wisnia1998/DDS-generator/README.md

# DDS-generator
DDS generator based on Adruino board and AD9850 for PUE student classes

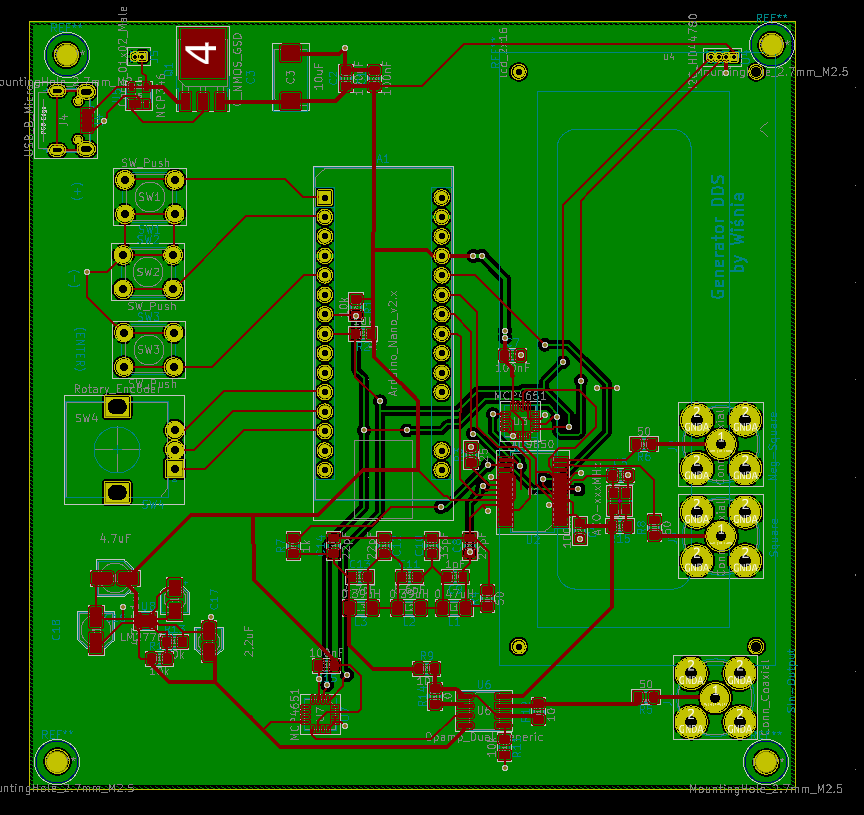
[picture p1: PCB_DDS.PNG]
