wisnia1998/DDS-generator/dds.kicad_pcb

## KiCad design dds.kicad_pcb (2020-10-13)

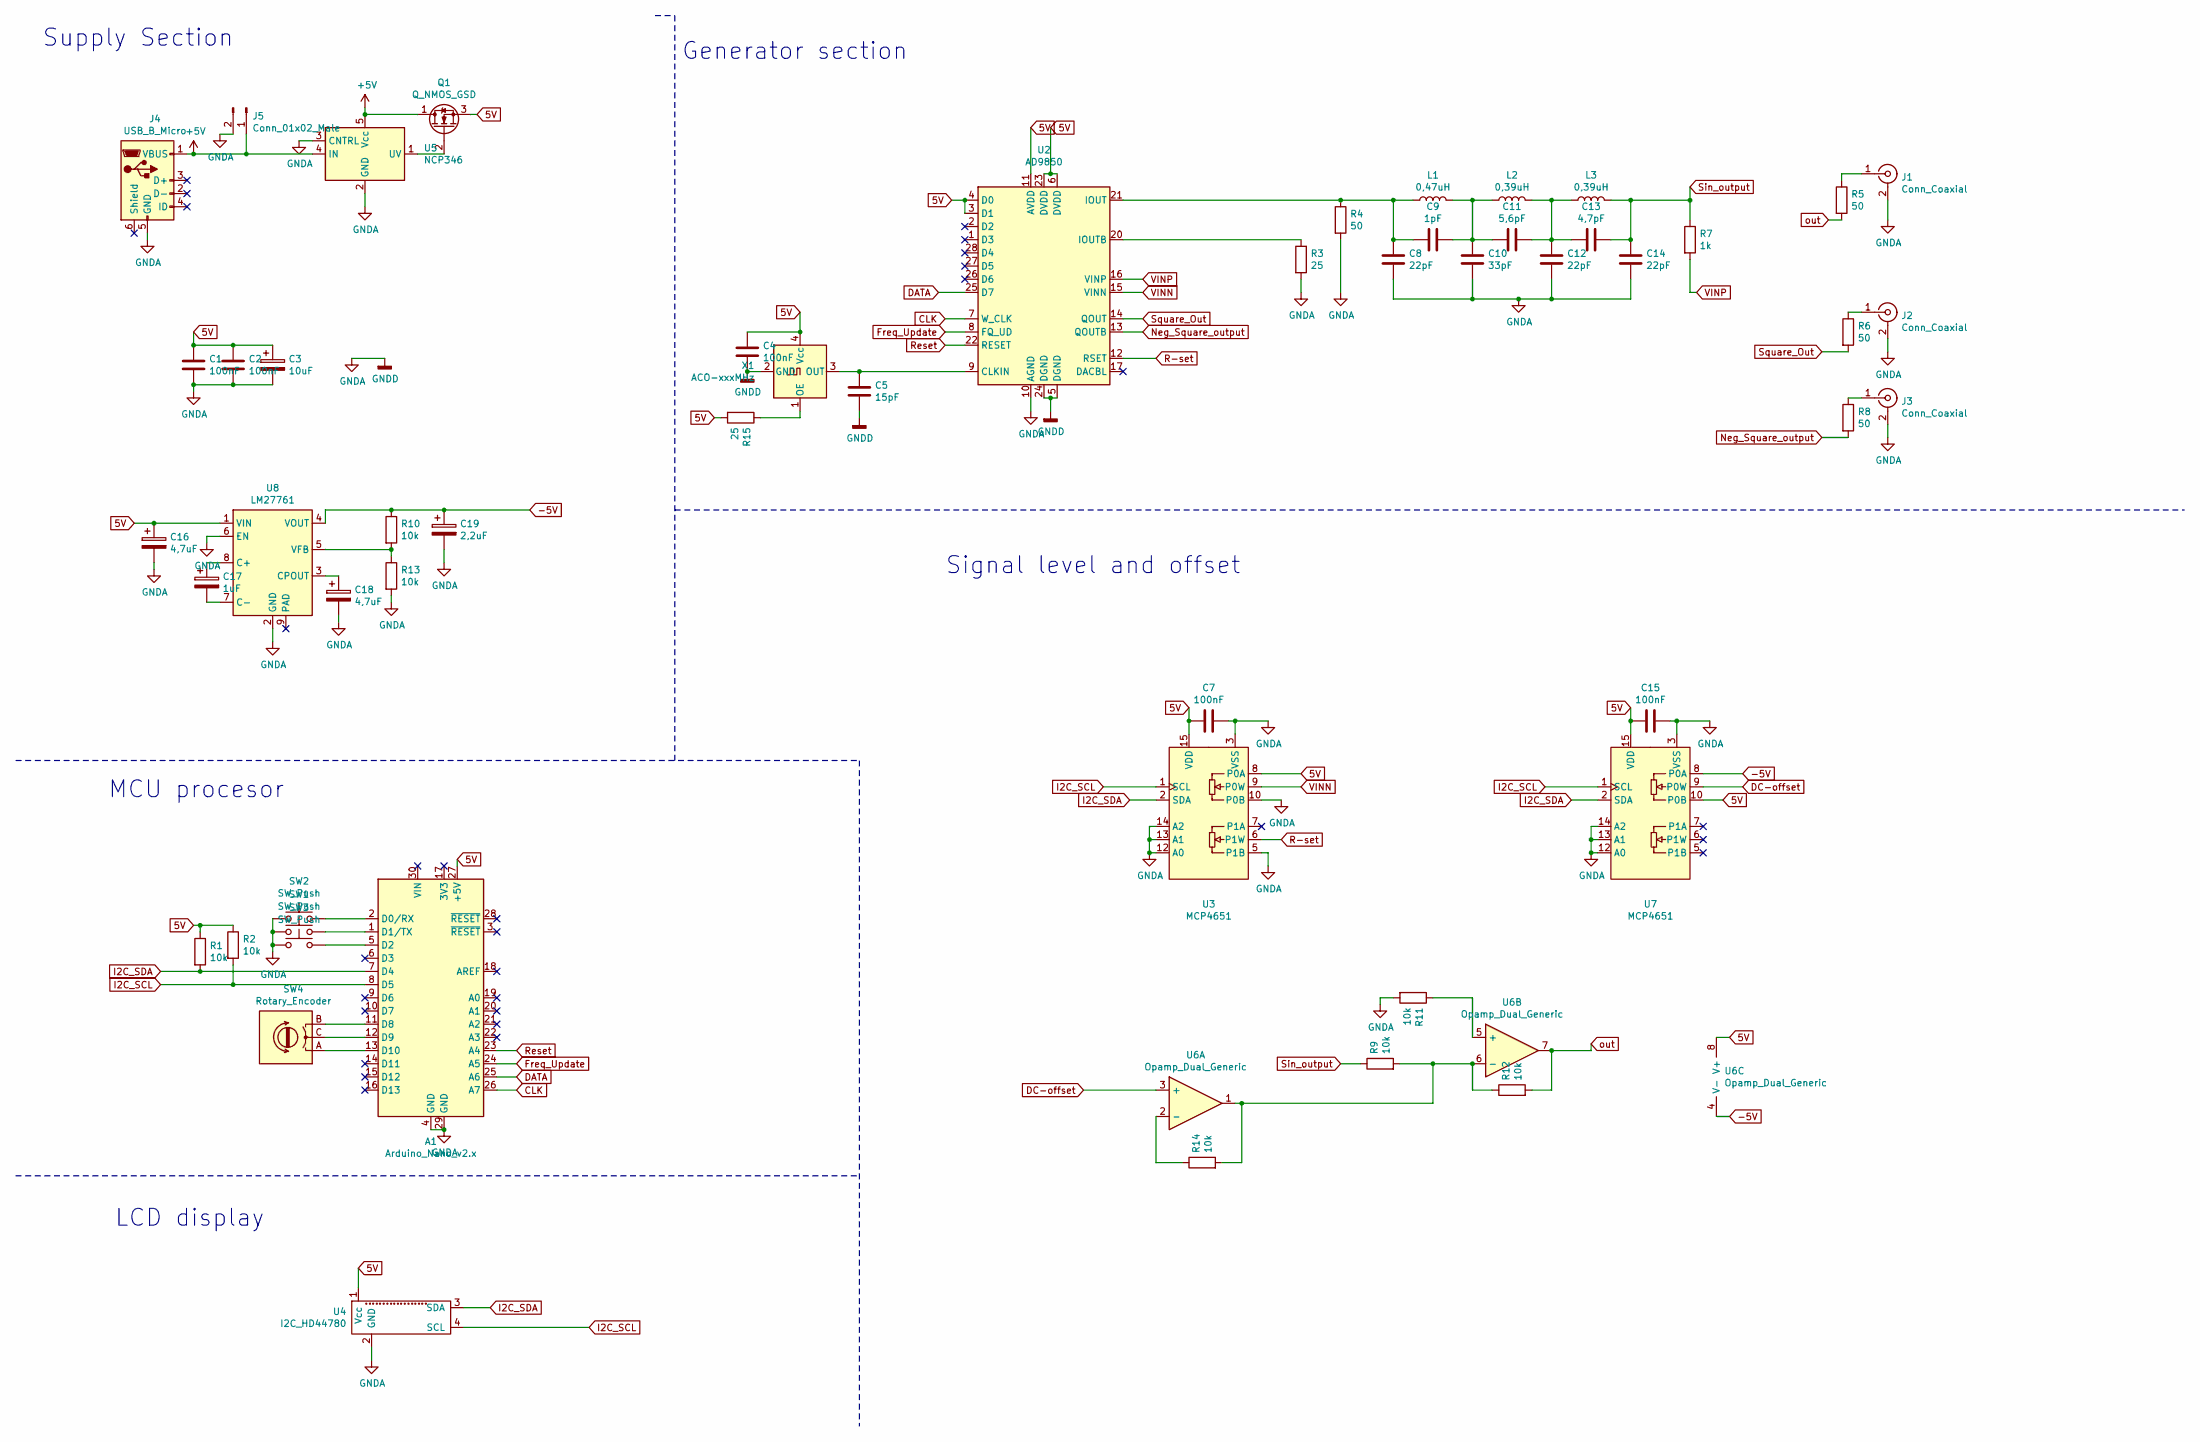
[picture p24: schematic dds.sch, DDS Generator]

Parts:
A1: Arduino_Nano_v2.x; Arduino_Nano
C1, C2, C4, C7, C15: 100nF; C_0805_2012Metric_Pad1.15x1.40mm_HandSolder
C3: 10uF; C_Elec_8x6.2
C5: 15pF; C_0805_2012Metric_Pad1.15x1.40mm_HandSolder
C8, C12, C14: 22pF; C_0805_2012Metric_Pad1.15x1.40mm_HandSolder
C9: 1pF; C_0805_2012Metric_Pad1.15x1.40mm_HandSolder
C10: 33pF; C_0805_2012Metric_Pad1.15x1.40mm_HandSolder
C11: 5,6pF; C_0805_2012Metric_Pad1.15x1.40mm_HandSolder
C13: 4,7pF; C_0805_2012Metric_Pad1.15x1.40mm_HandSolder
C16, C18: 4,7uF; C_Elec_8x6.2
C17: 1uF; C_Elec_8x6.2
C19: 2,2uF; C_Elec_8x6.2
J1, J2, J3: Conn_Coaxial; BNC_TEConnectivity_1478204_Vertical
J4: USB_B_Micro; USB_Micro-B_Wuerth_629105150521
J5: Conn_01x02_Male; PinHeader_1x02_P1.00mm_Vertical
L1: 0,47uH; L_1206_3216Metric_Pad1.42x1.75mm_HandSolder
L2, L3: 0,39uH; L_1206_3216Metric_Pad1.42x1.75mm_HandSolder
Q1: Q_NMOS_GSD; TO-252-3_TabPin4
R1, R2, R9, R10, R11, R12, R13, R14: 10k; R_0805_2012Metric_Pad1.15x1.40mm_HandSolder
R3, R15: 25; R_0805_2012Metric_Pad1.15x1.40mm_HandSolder
R4, R5, R6, R8: 50; R_0805_2012Metric_Pad1.15x1.40mm_HandSolder
R7: 1k; R_0805_2012Metric_Pad1.15x1.40mm_HandSolder
SW1, SW2, SW3: SW_Push; SW_PUSH_6mm
SW4: Rotary_Encoder; RotaryEncoder_Alps_EC12E_Vertical_H20mm
U2: AD9850; SSOP-28_5.3x10.2mm_P0.65mm
U3, U7: MCP4651; QFN-16-1EP_4x4mm_P0.65mm_EP2.5x2.5mm
U4: I2C_HD44780; PinHeader_1x18_P1.00mm_Vertical
U5: NCP346; SOT-23-6
U6: Opamp_Dual_Generic; HSOP-8-1EP_3.9x4.9mm_P1.27mm_EP2.41x3.1mm
U8: LM27761; WSON-8-1EP_2x2mm_P0.5mm_EP0.9x1.6mm
X1: ACO-xxxMHz; Oscillator_SMD_TXC_7C-4Pin_5.0x3.2mm

Connections:
5V: A1.27 (+5V), C1.1, C2.1, C3.1, C4.1, C7.1, C15.1, C16.1, Q1.3 (S), R1.1, R2.1, R15.2, U2.3 (D1), U2.4 (D0), U2.6 (DVDD), U2.11 (AVDD), U2.18 (AVDD), U2.23 (DVDD), U3.8 (P0A), U3.15 (VDD), U4.1 (Vcc), U6.8 (V+), U7.10 (P0B), U7.15 (VDD), U8.1 (VIN), X1.4 (Vcc)
+5V: J4.1 (VBUS), J5.1, Q1.1 (D), U5.4 (IN), U5.5 (Vcc)
-5V: C19.1, R10.1, U6.4 (V-), U7.8 (P0A), U8.4 (VOUT)
CLK: A1.26 (A7), U2.7 (W_CLK)
DATA: A1.25 (A6), U2.25 (D7)
DC-offset: U6.3 (+), U7.9 (P0W)
Freq_Update: A1.24 (A5), U2.8 (FQ_UD)
I2C_SCL: A1.8 (D5), R2.2, U3.1 (SCL), U4.4 (SCL), U7.1 (SCL)
I2C_SDA: A1.7 (D4), R1.2, U3.2 (SDA), U4.3 (SDA), U7.2 (SDA)
Neg_Square_output: R8.2, U2.13 (QOUTB)
unnamed: A1.1 (D1/TX), SW1.2
unnamed: A1.2 (D0/RX), SW2.2
unnamed: A1.5 (D2), SW3.2
unnamed: A1.11 (D8), SW4.B
unnamed: A1.12 (D9), SW4.C
unnamed: A1.13 (D10), SW4.A
unnamed: C5.1, U2.9 (CLKIN), X1.3 (OUT)
unnamed: C8.1, C9.1, L1.1, R4.1, U2.21 (IOUT)
unnamed: C9.2, C10.1, C11.2, L1.2, L2.1
unnamed: C11.1, C12.2, C13.2, L2.2, L3.1
unnamed: C17.1, U8.8 (C+)
unnamed: C17.2, U8.7 (C-)
unnamed: C18.1, U8.3 (CPOUT)
unnamed: J1.1 (In), R5.1
unnamed: J2.1 (In), R6.1
unnamed: J3.1 (In), R8.1
unnamed: Q1.2 (G), U5.1 (UV)
unnamed: R3.1, U2.20 (IOUTB)
unnamed: R10.2, R13.1, U8.5 (VFB)
unnamed: R11.1, U6.5 (+)
unnamed: R9.2, R12.1, R14.2, U6.1, U6.6 (-)
unnamed: R14.1, U6.2 (-)
unnamed: R15.1, X1.1 (OE)
R-set: U2.12 (RSET), U3.6 (P1W)
Reset: A1.23 (A4), U2.22 (RESET)
Sin_output: C13.1, C14.1, L3.2, R7.1, R9.1
Square_Out: R6.2, U2.14 (QOUT)
VINN: U2.15 (VINN), U3.9 (P0W)
VINP: R7.2, U2.16 (VINP)
out: R5.2, R12.2, U6.7

Notes on the sheet:
Supply Section
Generator section
MCU procesor
LCD display
Signal level and offset

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
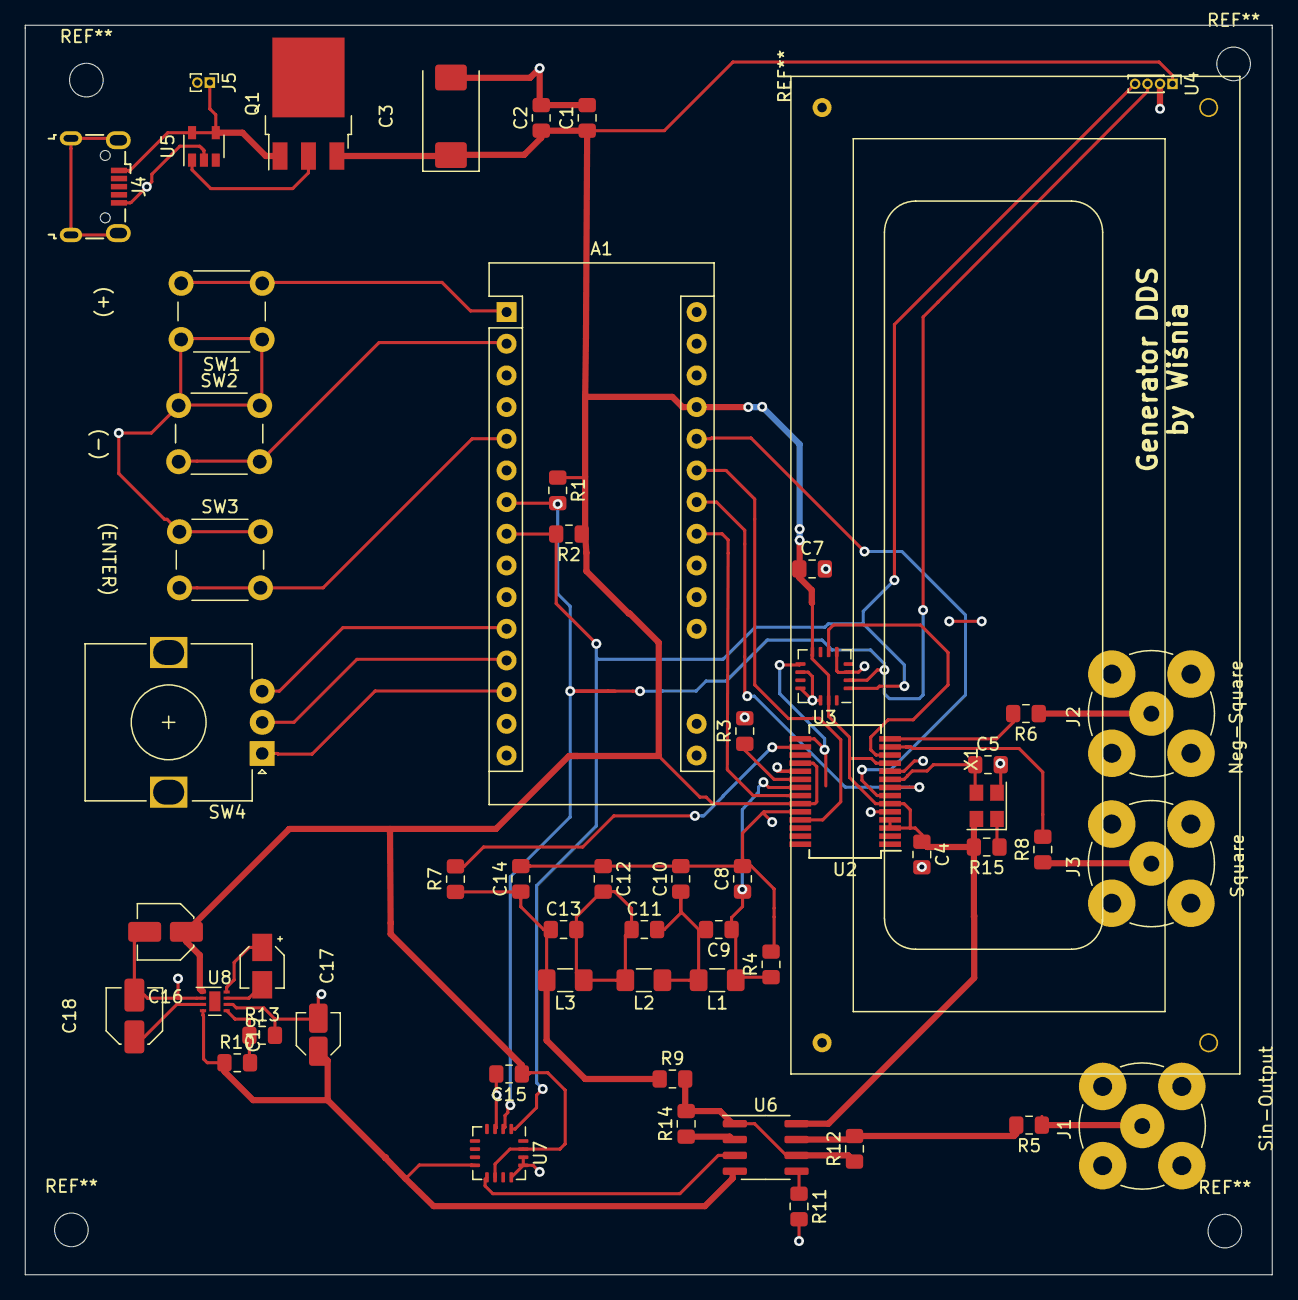
[picture p25: board dds.kicad_pcb from above]

Board: 2 copper layers, 100.0 x 100.2 mm, 55 parts (0 on the bottom side), 41 nets.
